lhxj/RT-Thread-Based-Smart-Cat-Litter-Box/docs/hardware-config.md

# 硬件配置与引脚说明

本文用于说明当前仓库所对应的硬件组成、代码中已经接入的外设，以及实际引脚配置。

整理原则如下：

- 以仓库内现有代码和 BSP 配置为准
- 参考物料清单用于说明硬件构成，不等同于“当前代码全部已接入”
- 对于仓库中没有明确 GPIO / 总线绑定的器件，单独标注为“未在代码中形成明确约束”

## 1. 平台与板级基础

### 主控平台

- MCU：`HC32F460`
- RTOS：`RT-Thread`
- 控制台串口：`uart4`
- 联网模组：`ESP8266 AT Device`

### 板级总线与外设开关

当前 BSP / 软件包配置可从 [`rtconfig.h`](../rtconfig.h) 确认：

- `BSP_USING_UART2`
- `BSP_USING_UART4`
- `BSP_USING_I2C2`
- `PKG_USING_AT_DEVICE`
- `AT_DEVICE_USING_ESP8266`
- `PKG_USING_DHT11`
- `PKG_USING_SSD1306`
- `PKG_USING_BALANCE`

## 2. 参考物料清单对照

| 物料 | 数量 | 当前代码状态 | 说明 |
| --- | --- | --- | --- |
| 18650 电池 | 3 | 供电件 | 仓库中无软件配置 |
| 18650 电池充电器 | 1 | 供电件 | 仓库中无软件配置 |
| HX711 模块 | 1 | 已接入 | 通过 `balance` 软件包使用，当前只启用 `CH0` |
| OLED 屏幕 | 1 | 已接入 | 使用 SSD1306，挂载在 `i2c2` |
| 370 减速电机 | 1 | 已接入 | 通过 `IN1/IN2` 控制正反转与停机 |
| 臭氧发生器 | 1 | 已预留控制输出 | 有 GPIO 输出，当前只实现关闭控制，未实现独立使能策略 |
| 磁铁 | 1 | 机械件 | 与霍尔位置检测配合，仓库中无单独 GPIO |
| 三霍尔位置传感板 | 1 | 已接入 | `PA4/PA5/PA6` |
| 电池盒 | 1 | 供电件 | 仓库中无软件配置 |
| 继电器 | 1 | 未在代码中形成明确约束 | 当前代码没有单独的继电器控制 GPIO |
| L298N 电机驱动 | 1 | 已接入 | 电机方向输出为 `PD8/PD9` |
| DHT11 温湿度传感器 | 1 | 已接入 | 数据脚为 `PE10` |
| 蜂鸣器 | 1 | 已预留控制输出 | 有 GPIO 输出，当前只实现关闭控制，未实现独立使能策略 |
| 面包板 | 1 | 搭建件 | 仓库中无软件配置 |
| 杜邦线公对公 | 1 | 搭建件 | 仓库中无软件配置 |
| 杜邦线母对母 | 1 | 搭建件 | 仓库中无软件配置 |
| 红外传感器 | 1 | 已接入 | 占用检测输入 `PE2` |
| ESP8266 | 1 | 已接入 | `uart2` AT 设备 |
| 置物箱 | 1 | 结构件 | 仓库中无软件配置 |
| 小华开发板 | 1 | 已接入 | 对应 HC32F460 开发板 |

## 3. 当前代码已接入的硬件

### 3.1 机电控制相关

| 模块 | 接口 | 引脚 | 说明 |
| --- | --- | --- | --- |
| 红外占用检测 | GPIO 输入 | `PE2` | 低电平表示占用 |
| 电机驱动 L298N | GPIO 输出 | `PD8` / `PD9` | 方向控制，见下文动作表 |
| 三霍尔位置反馈 | GPIO 输入 | `PA4` / `PA5` / `PA6` | 上拉输入，低电平有效 |
| 臭氧输出 | GPIO 输出 | `PD10` | 当前只实现关闭控制，未实现独立使能策略 |
| 蜂鸣器输出 | GPIO 输出 | `PD11` | 当前只实现关闭控制，未实现独立使能策略 |

### 3.2 传感与显示

| 模块 | 接口 | 引脚 / 总线 | 说明 |
| --- | --- | --- | --- |
| DHT11 | 单总线 GPIO | `PE10` | 温湿度采样 |
| OLED SSD1306 | 软件 I2C | `i2c2` | 地址 `0x3C` |
| HX711 / balance | GPIO bit-bang | `PC0` / `PC1` | 当前仅启用 `balance0`，即 CH0 |

### 3.3 联网与调试

| 模块 | 接口 | 引脚 | 说明 |
| --- | --- | --- | --- |
| ESP8266 | `uart2` | `PA2` / `PA3` | 用于 AT Device 联网 |
| 串口控制台 | `uart4` | `PE6` / `PB9` | RT-Thread 控制台和 finsh |
| 板载 LED | GPIO 输出 | `PD4` | 主循环心跳闪烁 |

## 4. 快速接线表

这一节按“模块 -> MCU 引脚”的形式给出快速接线视图，适合搭板和复核。

### 4.1 核心控制链路

| 模块 | 模块信号 | MCU 引脚 | 备注 |
| --- | --- | --- | --- |
| 红外传感器 | OUT | `PE2` | 低电平表示占用 |
| L298N | IN1 | `PD8` | 电机方向控制 1 |
| L298N | IN2 | `PD9` | 电机方向控制 2 |
| 霍尔板 | POS1 | `PA4` | `POS1_HOME`，低电平有效 |
| 霍尔板 | POS2 | `PA5` | `POS2_DUMP`，低电平有效 |
| 霍尔板 | POS3 | `PA6` | `POS3_SAND_RETURN`，低电平有效 |
| DHT11 | DATA | `PE10` | 单总线数据脚 |
| 蜂鸣器 | CTRL | `PD11` | 预留控制输出 |
| 臭氧发生器 | CTRL | `PD10` | 预留控制输出 |

### 4.2 显示、称重与联网

| 模块 | 模块信号 | MCU 引脚 / 总线 | 备注 |
| --- | --- | --- | --- |
| OLED SSD1306 | SCL | `PD0` / `i2c2_scl` | 软件 I2C |
| OLED SSD1306 | SDA | `PD1` / `i2c2_sda` | 软件 I2C |
| HX711 | DOUT | `PC0` | 当前仅启用 `balance0` |
| HX711 | SCK | `PC1` | 当前仅启用 `balance0` |
| ESP8266 | RX | `PA2` | MCU `uart2_tx` -> ESP8266 RX |
| ESP8266 | TX | `PA3` | MCU `uart2_rx` <- ESP8266 TX |
| 调试串口 | TX | `PE6` | MCU `uart4_tx` -> USB 转串口 RX |
| 调试串口 | RX | `PB9` | MCU `uart4_rx` <- USB 转串口 TX |

### 4.3 电源与公共约束

这一部分不属于仓库内的软件引脚配置，但接线时建议满足以下基础条件：

- 所有外设与主控共地
- 外设供电电压和 IO 电平以模块规格书为准
- ESP8266、OLED、HX711、DHT11 等模块上电后再进行软件联调
- 霍尔板、红外和电机驱动的信号地与主控地保持可靠连接

## 5. 硬件连接总览

下面的文本图用于建立整体接线认知，适合在接手项目时快速过一遍。

```text
                +----------------------+
                |      HC32F460        |
                |                      |
 红外占用  ----> | PE2                  |
 霍尔 POS1 ----> | PA4                  |
 霍尔 POS2 ----> | PA5                  |
 霍尔 POS3 ----> | PA6                  |
 DHT11 DATA --> | PE10                 |
 HX711 DOUT --> | PC0                  |
 HX711 SCK  --> | PC1                  |
 OLED SCL  <--> | PD0  (i2c2)          |
 OLED SDA  <--> | PD1  (i2c2)          |
 ESP8266 RX <-- | PA2  (uart2_tx)      |
 ESP8266 TX --> | PA3  (uart2_rx)      |
 Console TX --> | PE6  (uart4_tx)      |
 Console RX <-- | PB9  (uart4_rx)      |
 L298N IN1  <-- | PD8                  |
 L298N IN2  <-- | PD9                  |
 Buzzer CTRL <- | PD11                 |
 O3 CTRL     <- | PD10                 |
 LED         <- | PD4                  |
                +----------------------+
```

说明：

- 输入 / 输出方向均从 MCU 视角描述
- `uart2` 用于 ESP8266 联网
- `uart4` 用于日志、控制台和 finsh
- `i2c2` 为软件 I2C，总线引脚由 `rtconfig.h` 配置为 `PD0 / PD1`

## 6. 详细引脚表

### 6.1 应用层 GPIO 映射

下表对应 [`applications/main.c`](../applications/main.c) 与 [`app_logic/logic.c`](../app_logic/logic.c) 中直接使用的引脚。

| MCU 引脚 | 信号名 | 方向 | 有效电平 / 动作 | 对应硬件 |
| --- | --- | --- | --- | --- |
| `PE2` | `HONGWAI_PIN` | 输入 | `PIN_LOW = occupied` | 红外传感器 |
| `PD8` | `IN1` | 输出 | 电机方向控制 | L298N |
| `PD9` | `IN2` | 输出 | 电机方向控制 | L298N |
| `PD10` | `O3` | 输出 | 预留臭氧控制输出 | 臭氧发生器 |
| `PD11` | `BUZZER` | 输出 | 预留蜂鸣器控制输出 | 蜂鸣器 |
| `PE10` | `DHT11_DATA_PIN` | 输入 / 输出 | DHT11 单总线数据 | DHT11 |
| `PA4` | `HALL_POS1_HOME_PIN` | 输入上拉 | 低电平有效 | 霍尔位置 1 |
| `PA5` | `HALL_POS2_DUMP_PIN` | 输入上拉 | 低电平有效 | 霍尔位置 2 |
| `PA6` | `HALL_POS3_SAND_RETURN_PIN` | 输入上拉 | 低电平有效 | 霍尔位置 3 |
| `PD4` | `LED_GREEN_PIN` | 输出 | 心跳闪烁 | 板载 LED |
| `PD3` | `LED0_PIN` | 已定义 | 当前主线未使用 | 板载 LED |
| `PD5` | `LED2_PIN` | 已定义 | 当前主线未使用 | 板载 LED |
| `PD6` | `LED3_PIN` | 已定义 | 当前主线未使用 | 板载 LED |

### 6.2 电机动作定义

当前电机动作由 [`app_logic/logic.c`](../app_logic/logic.c) 中的输出组合定义：

| 动作 | `PD8 / IN1` | `PD9 / IN2` |
| --- | --- | --- |
| 正转 | `LOW` | `HIGH` |
| 反转 | `HIGH` | `LOW` |
| 停机 | `LOW` | `LOW` |

### 6.3 Hall 位置定义

当前三霍尔在软件中的位置语义如下：

| 引脚 | 位置名 | 机械语义 |
| --- | --- | --- |
| `PA4` | `POS1_HOME` | 待机 / 回零位置 |
| `PA5` | `POS2_DUMP` | 倒砂位置 |
| `PA6` | `POS3_SAND_RETURN` | 砂回流位置 |

补充说明：

- 三路霍尔使用输入上拉配置
- 低电平表示当前霍尔触发
- 代码按 one-hot 方式解码稳定位置

## 7. 总线与串口配置

### 7.1 `uart4` 控制台

控制台相关配置来自 [`rtconfig.h`](../rtconfig.h) 和 [`board/board_config.h`](../board/board_config.h)：

| 项目 | 配置 |
| --- | --- |
| 设备名 | `uart4` |
| MCU TX | `PE6` |
| MCU RX | `PB9` |
| 默认串口参数 | `115200 8N1` |
| 用途 | RT-Thread 控制台、日志、finsh |

接线时通常遵循：

- 外部 USB 转串口 RX <- `PE6`
- 外部 USB 转串口 TX -> `PB9`

### 7.2 `uart2` ESP8266

ESP8266 相关配置来自 [`rtconfig.h`](../rtconfig.h) 与 [`board/board_config.h`](../board/board_config.h)：

| 项目 | 配置 |
| --- | --- |
| 设备名 | `uart2` |
| MCU TX | `PA2` |
| MCU RX | `PA3` |
| 用途 | ESP8266 AT Device |

接线时通常遵循：

- ESP8266 RX <- `PA2`
- ESP8266 TX -> `PA3`

说明：

- 仓库当前明确配置了 `uart2` 作为 ESP8266 AT client
- 仓库里没有看到 ESP8266 `EN` / `RST` / `IO0` 等额外控制脚的项目级绑定

### 7.3 `i2c2` OLED

OLED 使用软件 I2C，总线名为 `i2c2`。

| 项目 | 配置 |
| --- | --- |
| 总线名 | `i2c2` |
| SCL 配置值 | `48` |
| SDA 配置值 | `49` |
| 实际端口 | `PD0` / `PD1` |
| OLED 地址 | `0x3C` |

引脚换算依据：

- `GET_PIN(PORT, PIN) = port_index * 16 + pin`
- HC32 GPIO 端口编号：`A=0`、`B=1`、`C=2`、`D=3`、`E=4`
- 因此 `48 = 3*16 + 0 = PD0`，`49 = 3*16 + 1 = PD1`

## 8. HX711 / 称重通道说明

`balance` 软件包当前只启用了 `CH0`：

| 通道 | DOUT | SCLK | 状态 |
| --- | --- | --- | --- |
| `balance0` | `PC0` | `PC1` | 已启用 |
| `balance1` | 未配置 | 未配置 | 未启用 |
| `balance2` | 未配置 | 未配置 | 未启用 |

补充说明：

- 当前业务逻辑中的重量来源是 `cur_weight`
- 满仓阈值判断使用 `cur_weight >= 500`
- 仓库里虽然启用了 `ADC1`，但当前称重主线并不走 ADC，而是通过 HX711 bit-bang 驱动

## 9. 当前未形成明确引脚约束的器件

以下器件在参考物料清单中出现，但当前仓库没有形成单独、明确的引脚配置文档约束：

- 继电器
- 电池 / 电池盒 / 充电器
- 面包板、杜邦线
- 置物箱
- 磁铁本体

其中：

- 磁铁是 Hall 机械结构的一部分，软件只关心 Hall 输入结果
- 供电和结构件属于系统装配信息，不在当前仓库的软件引脚配置范围内

## 10. 接手开发时的建议

如果需要继续调试或扩展硬件，建议按下面顺序确认：

1. 先确认 `uart4` 控制台、`uart2` 联网、`i2c2` OLED 三条基础链路
2. 再确认 `PE2`、`PA4/PA5/PA6`、`PD8/PD9` 这些控制闭环关键引脚
3. 最后再补充未形成明确约束的辅助器件文档

配套文档：

- [`architecture.md`](architecture.md)
- [`debug-and-demo.md`](debug-and-demo.md)
