lhxj/RT-Thread-Based-Smart-Cat-Litter-Box/app_logic/logic.h

/*
 * Copyright (c) 2006-2021, RT-Thread Development Team
 *
 * SPDX-License-Identifier: Apache-2.0
 *
 * Change Logs:
 * Date           Author       Notes
 * 2022-08-01     ywx       the first version
 */
#ifndef APPLICATIONS_APP_LOGIC_LOGIC_H_
#define APPLICATIONS_APP_LOGIC_LOGIC_H_

#include "fsm.h"

#define AHT10_I2C_BUS "i2c2"

#define ADC_DEV_NAME        "adc1"      /* ADC device name */
#define ADC_DEV_CHANNEL     12           /* ADC channel */
#define REFER_VOLTAGE       330          /* 3.3V reference voltage x100 */
#define CONVERT_BITS        (1 << 12)    /* 12-bit conversion range */

extern int box_used;

void access_Sensor(void);
void Sensor_Logic_Init(void);
void Sensor_Logic_UpdateInputs(void);
void Sensor_Logic_Running(void);
void Sensor_Logic_RequestClean(void);
void Sensor_Logic_RequestReset(void);
litter_fsm_state_t Sensor_Logic_GetState(void);
int Sensor_Logic_GetFaultCode(void);
const char *Sensor_Logic_StateName(void);
const char *Sensor_Logic_FaultName(void);
const char *Sensor_Logic_CleanPhaseName(void);
const char *Sensor_Logic_HallPositionName(void);
rt_bool_t Sensor_Logic_IsBinFull(void);
rt_bool_t Sensor_Logic_IsProtectActive(void);

#endif /* APPLICATIONS_APP_LOGIC_LOGIC_H_ */
