lhxj/RT-Thread-Based-Smart-Cat-Litter-Box/(commit log)

2026-04-09 feat: initial import smart litter box project with README
    [kconfig-language.txt, kconfig.txt]
2026-04-09 refactor: 引入清理流程状态机骨架
2026-04-09 fix: 收尾修复状态机构建与恢复路径
2026-04-09 fix: 关闭缺失示例配置以恢复 SCons 构建
2026-04-10 实现任务包2安全联锁
2026-04-10 统一bin_full恢复联锁语义
2026-04-10 feat: 完善故障恢复与关键告警
2026-04-11 Implement hall-based cleaning loop and phase-entry fix
    [app_init.c, fsm.c, fsm.h, logic.c, logic.h]
